sameddudley/minicam_et/docs/wiring_diagram_minicam_et.jpg

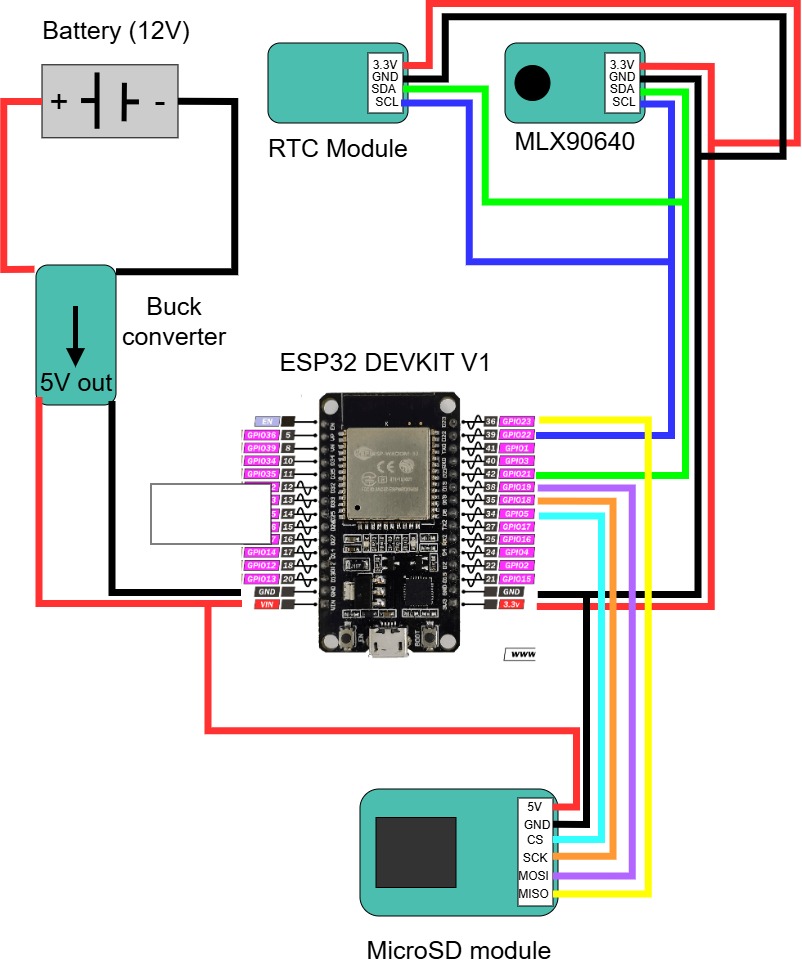
docs/wiring_diagram_minicam_et.jpg
