sameddudley/minicam_et/thermal_sensing_et/Wärmebildkamera-Gehäuse v49.stl

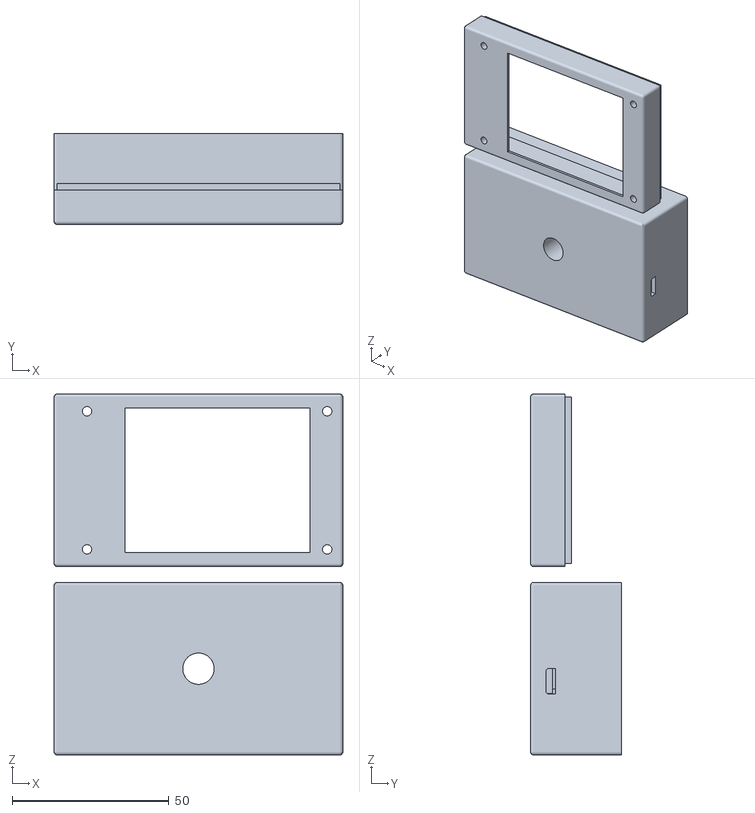
[picture p2: CAD file, 2026-08-19, last stored version]
thermal_sensing_et/Wärmebildkamera-Gehäuse v49.stl
92.0 x 29.0 x 115.0
