sameddudley/minicam_et/(list of files, cad)

Other CAD files:
thermal_sensing_et/Wärmebildkamera-Gehäuse-v49.f3d
