sameddudley/minicam_et/python/test_data_output/dht_log.csv

timestamp_ms | temperature_C | humidity_pct
2389 | 26.8 | 43.0
4419 | 26.8 | 43.0
6450 | 27.0 | 43.0
8481 | 27.0 | 43.0
10516 | 26.8 | 43.0
12545 | 26.8 | 42.0
14576 | 26.8 | 42.0
16607 | 26.8 | 42.0
18638 | 27.0 | 42.0
20689 | 26.8 | 42.0
22700 | 26.8 | 42.0
24731 | 26.8 | 42.0
26763 | 26.8 | 42.0
28794 | 26.8 | 42.0
30825 | 26.8 | 42.0
32856 | 26.8 | 42.0
