sameddudley/minicam_et/python/test_data_output/dht_log_saws.csv

timestamp_ms | temperature_C | humidity_pct
2180 | 23.8 | 47.0
4213 | 24.4 | 47.0
6242 | 24.4 | 47.0
8273 | 24.4 | 46.0
10304 | 24.4 | 46.0
12337 | 24.4 | 46.0
14368 | 24.4 | 46.0
16399 | 24.4 | 46.0
18430 | 24.4 | 46.0
20461 | 24.3 | 46.0
22494 | 24.4 | 46.0
24523 | 24.3 | 46.0
26554 | 24.4 | 46.0
28585 | 24.3 | 46.0
30616 | 24.3 | 46.0
32664 | 24.3 | 46.0
34678 | 24.3 | 46.0
36710 | 24.3 | 46.0
38741 | 24.4 | 46.0
40772 | 24.3 | 46.0
42805 | 24.3 | 46.0
44836 | 24.3 | 46.0
46865 | 24.3 | 46.0
48898 | 24.3 | 46.0
50927 | 24.3 | 46.0
52958 | 24.3 | 46.0
54991 | 24.2 | 46.0
57021 | 24.3 | 46.0
59052 | 24.3 | 46.0
61083 | 24.3 | 46.0
63114 | 24.2 | 46.0
65165 | 24.3 | 46.0
67176 | 24.2 | 46.0
69207 | 24.2 | 46.0
71239 | 24.3 | 46.0
73270 | 24.2 | 46.0
75301 | 24.2 | 46.0
77332 | 24.2 | 46.0
79363 | 24.2 | 46.0
81394 | 24.2 | 46.0
83425 | 24.1 | 46.0
85456 | 24.1 | 46.0
87489 | 24.2 | 46.0
89518 | 24.1 | 46.0
91550 | 24.3 | 46.0
93581 | 24.4 | 46.0
95612 | 24.1 | 46.0
97663 | 24.1 | 46.0
99677 | 24.1 | 46.0
101706 | 24.1 | 46.0
103737 | 24.1 | 46.0
105768 | 24.1 | 46.0
107801 | 24.1 | 46.0
109830 | 24.1 | 46.0
111861 | 24.1 | 46.0
113892 | 24.1 | 46.0
115923 | 24.1 | 46.0
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
