sameddudley/minicam_et/python/test_data_output/breadboard_test.gif

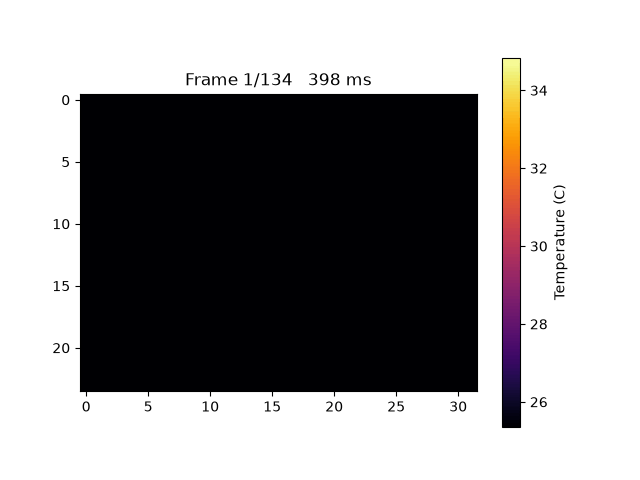
python/test_data_output/breadboard_test.gif
