sameddudley/minicam_et/(commit log)

2026-08-24 added code to set up camera and log at 1hz
2026-09-10 commented and edited stats (stable with some issues)
    [decode_thermal_log.py, thermal_sensing_et.ino]
2026-09-10 fixed .5hz logging issue and weird RTC issue; reduced code bloat
    [rtc_time_sync.py, thermal_sensing_et.ino]
2026-09-10 fixed skipped timestamp issue
    [thermal_sensing_et.ino]
2026-09-15 added folders for documentation and future dev
    [Wärmebildkamera-Gehäuse v49.stl, Wärmebildkamera-Gehäuse-v49.f3d]
2026-09-28 added wiring diagram
2026-09-28 added editable wiring diagram for draw.io to docs
